DustinNgauv/Sparring-Roboter/Main/Screens.ino

void drawHomeScreen() {
  myGLCD.clrScr();
  myButtons.deleteAllButtons();
  myGLCD.setBackColor(0, 0, 0); // background color to black
  myGLCD.setColor(255, 255, 255); // font color to white
  myGLCD.setFont(GroteskBold24x48);

  // draws title
  myGLCD.print("Sparring Mode", CENTER, 15);
  myGLCD.drawLine(0, 80, 800, 80);

  // setting buttons
  myButtons.setTextFont(GroteskBold24x48);
  myButtons.setButtonColors(VGA_WHITE, VGA_GRAY, VGA_BLACK, VGA_WHITE, VGA_RED);  
  int Rounds_btn = myButtons.addButton(200, 100, 150, 60, "");
  int Speed_btn = myButtons.addButton(450, 100, 150, 60, "");
  int Time_btn = myButtons.addButton(200, 200, 150, 60, "");
  int Level_btn = myButtons.addButton(450, 200, 150, 60, "");
  int Rest_btn = myButtons.addButton(200, 300, 150, 60, "");
  int Volume_btn = myButtons.addButton(450, 300, 150, 60, "");
  
  myButtons.drawButtons();

  // start button
  myButtons.setButtonColors(VGA_WHITE, VGA_GRAY, VGA_BLACK, VGA_WHITE, 0x04A7);
  int Start_btn = myButtons.addButton(300, 380, 200, 80, "START");
  myButtons.drawButton(Start_btn);

  // print lables of the setting buttons
  myGLCD.setFont(SmallFont);
  myGLCD.setBackColor(255, 0, 0);
  myGLCD.print("Rounds", 253, 105);
  myGLCD.print("Speed", 506, 105);
  myGLCD.print("Time", 260, 205);
  myGLCD.print("Level", 509, 205);
  myGLCD.print("Rest", 262, 305);
  myGLCD.print("Strike Volume", 475, 305);

  // print current values of the settings
  myGLCD.setFont(BigFont);
  myGLCD.printNumI(rounds, 250, 125, 2);
  myGLCD.print(String(speed) + "%", 508, 125);
  myGLCD.print(millisToTimeStr(time), 230, 225);
  myGLCD.printNumI(level, 521, 225);
  myGLCD.print(millisToTimeStr(rest), 230, 325);
  myGLCD.printNumI(volume, 520, 325);

  // checks for user inputs and button presses
  while (true) {
    if (myTouch.dataAvailable()) {
      int pressed = myButtons.checkButtons();

      if (pressed == Rounds_btn) {
        drawRoundsScreen();
      } else if (pressed == Speed_btn) {


        drawSpeedScreen();
      } else if (pressed == Time_btn) {
        drawTimeScreen();
      } else if (pressed == Level_btn) {
        drawLevelScreen();
      } else if (pressed == Rest_btn) {
        drawRestScreen();
      } else if (pressed == Volume_btn) {
        drawVolumeScreen();
      } else if (pressed == Start_btn) {        
        drawSparringScreen();
      }     
    }
  }
}

void drawRoundsScreen() {
  myGLCD.clrScr();
  myButtons.deleteAllButtons();
  myGLCD.setBackColor(0, 0, 0);
  myGLCD.setColor(255, 255, 255);
  myGLCD.setFont(GroteskBold24x48);

  // draws title
  myGLCD.print("Choose Rounds", CENTER, 15);  
  myGLCD.drawLine(0, 80, 800, 80);

  // prints amount of rounds in the middle of the screen
  myGLCD.setFont(GroteskBold24x48);
  myGLCD.printNumI(rounds, CENTER, 220, 2);  

  // buttons to increase or decrease amount of rounds
  myButtons.setButtonColors(VGA_WHITE, VGA_GRAY, VGA_BLACK, VGA_BLACK, VGA_BLACK);
  int plus_btn = myButtons.addButton(500, 190, 100, 100, "+", BUTTON_NO_BORDER);
  int minus_btn = myButtons.addButton(200, 190, 100, 100, "-", BUTTON_NO_BORDER);
  myButtons.drawButtons();
  
  // ok button
  myButtons.setButtonColors(VGA_WHITE, VGA_GRAY, VGA_BLACK, VGA_WHITE, 0x04A7);
  int ok_btn = myButtons.addButton(300, 380, 200, 80, "OK");
  myButtons.drawButton(ok_btn);

  // checks for user inputs and button presses
  while (true) {     
    if (myTouch.dataAvailable()) {
    int pressed = myButtons.checkButtons();      
      
      if (pressed == ok_btn) {
        drawHomeScreen();
        break;
      }
      else if (pressed == plus_btn && rounds < 15) { // 15 rounds maximum
        rounds += 1;         
        myGLCD.printNumI(rounds, CENTER, 220, 2); // updates displayed value
      }

      else if (pressed == minus_btn && rounds > 1) { // 1 round mimimun
        rounds -= 1;           
        myGLCD.printNumI(rounds, CENTER, 220, 2); // updates displayed value
      }
    }
  }
}

void drawSpeedScreen() {
  myGLCD.clrScr();
  myButtons.deleteAllButtons();
  myGLCD.setBackColor(0, 0, 0);
  myGLCD.setColor(255, 255, 255);
  myGLCD.setFont(GroteskBold24x48);

  // draws title
  myGLCD.print("Adjust Speed", CENTER, 15);  
  myGLCD.drawLine(0, 80, 800, 80);

  // prints current speed setting
  myGLCD.setFont(GroteskBold24x48);
  myGLCD.printNumI(speed, CENTER, 220, 3);  
  myGLCD.print("%", 450, 220);

  // buttons to increase or decrease speed
  myButtons.setButtonColors(VGA_WHITE, VGA_GRAY, VGA_BLACK, VGA_BLACK, VGA_BLACK);
  int plus_btn = myButtons.addButton(500, 190, 100, 100, "+", BUTTON_NO_BORDER);
  int minus_btn = myButtons.addButton(200, 190, 100, 100, "-", BUTTON_NO_BORDER);
  myButtons.drawButtons();
  
  // ok button
  myButtons.setButtonColors(VGA_WHITE, VGA_GRAY, VGA_BLACK, VGA_WHITE, 0x04A7);
  int ok_btn = myButtons.addButton(300, 380, 200, 80, "OK");
  myButtons.drawButton(ok_btn);

  //checks for user input and button presses
  while (true) {     
    if (myTouch.dataAvailable()) {
    int pressed = myButtons.checkButtons();
      if (pressed == ok_btn) {
        drawHomeScreen();
        break;
      }
      else if (pressed == plus_btn && speed < 100) { // maximal speed at 100%
        speed += 5;         
        myGLCD.printNumI(speed, CENTER, 220, 3); // updates displayed value
      }

      else if (pressed == minus_btn && speed > 25) { // minimal speed at 25%
        speed -= 5;           
        myGLCD.printNumI(speed, CENTER, 220, 3); // updates displayed value
      }
    }
  }
}

void drawTimeScreen() {
  myGLCD.clrScr();
  myButtons.deleteAllButtons();
  myGLCD.setBackColor(0, 0, 0);
  myGLCD.setColor(255, 255, 255);
  myGLCD.setFont(GroteskBold24x48);

  // draws title
  myGLCD.print("Choose Time", CENTER, 15);  
  myGLCD.drawLine(0, 80, 800, 80);

  // prints the current duration of a round
  myGLCD.setFont(GroteskBold24x48);
  myGLCD.print(millisToTimeStr(time), CENTER, 220);  

  // buttons to increase or decrease duration
  myButtons.setButtonColors(VGA_WHITE, VGA_GRAY, VGA_BLACK, VGA_BLACK, VGA_BLACK);
  int plus_btn = myButtons.addButton(500, 190, 100, 100, "+", BUTTON_NO_BORDER);
  int minus_btn = myButtons.addButton(200, 190, 100, 100, "-", BUTTON_NO_BORDER);
  myButtons.drawButtons();
  
  myButtons.setButtonColors(VGA_WHITE, VGA_GRAY, VGA_BLACK, VGA_WHITE, 0x04A7);
  int ok_btn = myButtons.addButton(300, 380, 200, 80, "OK");
  myButtons.drawButton(ok_btn);

  // checks for user inputs and button presses
  while (true) {     
    if (myTouch.dataAvailable()) {
    int pressed = myButtons.checkButtons();
      if (pressed == ok_btn) {
        drawHomeScreen();
        break;
      }
      // maximal duration 10 minutes
      else if (pressed == plus_btn && time < 600000) { 
        time += 15000;         
        // updates displayed value
        myGLCD.print(millisToTimeStr(time), CENTER, 220);
      }
      // minimal duration 30 seconds
      else if (pressed == minus_btn && time > 30000) {
        time -= 15000;           
        // updates displayed value
        myGLCD.print(millisToTimeStr(time), CENTER, 220);
      }
    }
  }
}

void drawLevelScreen() {
  myGLCD.clrScr();
  myButtons.deleteAllButtons();
  myGLCD.setBackColor(0, 0, 0);
  myGLCD.setColor(255, 255, 255);
  myGLCD.setFont(GroteskBold24x48);

  // draws title
  myGLCD.print("Choose Level", CENTER, 15);  
  myGLCD.drawLine(0, 80, 800, 80);

  // level buttons 1-3
  myGLCD.setFont(SevenSegment96x144Num);
  myButtons.setButtonColors(VGA_WHITE, VGA_GRAY, VGA_BLACK, VGA_WHITE, VGA_RED);
  int Lvl1_btn = myButtons.addButton(120, 190, 100, 100, "1");
  int Lvl2_btn = myButtons.addButton(350, 190, 100, 100, "2");
  int Lvl3_btn = myButtons.addButton(580, 190, 100, 100, "3");

  myButtons.drawButtons();

  // checks for user input and button presses
  while (true) {     
    if (myTouch.dataAvailable()) {
    int pressed = myButtons.checkButtons();
      if (pressed == Lvl1_btn) {
        level = 1;
        drawHomeScreen();
        break;
      }
      else if (pressed == Lvl2_btn) {
        level = 2;
        drawHomeScreen();
        break;
      }
      else if (pressed == Lvl3_btn) {
        level = 3;
        drawHomeScreen();
        break;
      }
    }
  }
}

void drawRestScreen() {
  myGLCD.clrScr();
  myButtons.deleteAllButtons();
  myGLCD.setBackColor(0, 0, 0);
  myGLCD.setColor(255, 255, 255);
  myGLCD.setFont(GroteskBold24x48);

  // draws title
  myGLCD.print("Choose Rest", CENTER, 15);  
  myGLCD.drawLine(0, 80, 800, 80);

  // prints current resting time
  myGLCD.setFont(GroteskBold24x48);
  myGLCD.print(millisToTimeStr(rest), CENTER, 220);  

  // buttons to increase or decrease resting time
  myButtons.setButtonColors(VGA_WHITE, VGA_GRAY, VGA_BLACK, VGA_BLACK, VGA_BLACK);
  int plus_btn = myButtons.addButton(500, 190, 100, 100, "+", BUTTON_NO_BORDER);
  int minus_btn = myButtons.addButton(200, 190, 100, 100, "-", BUTTON_NO_BORDER);
  myButtons.drawButtons();
  
  // ok button
  myButtons.setButtonColors(VGA_WHITE, VGA_GRAY, VGA_BLACK, VGA_WHITE, 0x04A7);
  int ok_btn = myButtons.addButton(300, 380, 200, 80, "OK");
  myButtons.drawButton(ok_btn);

  // checks for user inputs and button presses
  while (true) {     
    if (myTouch.dataAvailable()) {
    int pressed = myButtons.checkButtons();
      if (pressed == ok_btn) {
        drawHomeScreen();
        break;
      }
      // maximal resting time 5 minutes
      else if (pressed == plus_btn && rest < 300000) {
        rest += 10000;         
        // updates displayed value
        myGLCD.print(millisToTimeStr(rest), CENTER, 220);
      }
      // minimal resting time 10 seconds
      else if (pressed == minus_btn && rest > 10000) {
        rest -= 10000;           
        // updates displayed value
        myGLCD.print(millisToTimeStr(rest), CENTER, 220); 
      }
    }
  }
}

void drawVolumeScreen() {
  myGLCD.clrScr();
  myButtons.deleteAllButtons();
  myGLCD.setBackColor(0, 0, 0);
  myGLCD.setColor(255, 255, 255);
  myGLCD.setFont(GroteskBold24x48);

  // draws title
  myGLCD.print("Choose Strike Volume", CENTER, 15);  
  myGLCD.drawLine(0, 80, 800, 80);

  // prints the current amount of consecutive strikes
  myGLCD.setFont(GroteskBold24x48);
  myGLCD.printNumI(volume, CENTER, 220);  

  // buttons to increase or decrease strike volume
  myButtons.setButtonColors(VGA_WHITE, VGA_GRAY, VGA_BLACK, VGA_BLACK, VGA_BLACK);
  int plus_btn = myButtons.addButton(500, 190, 100, 100, "+", BUTTON_NO_BORDER);
  int minus_btn = myButtons.addButton(200, 190, 100, 100, "-", BUTTON_NO_BORDER);
  myButtons.drawButtons();
  
  // ok button
  myButtons.setButtonColors(VGA_WHITE, VGA_GRAY, VGA_BLACK, VGA_WHITE, 0x04A7);
  int ok_btn = myButtons.addButton(300, 380, 200, 80, "OK");
  myButtons.drawButton(ok_btn);

  // checks for user input and button presses
  while (true) {     
    if (myTouch.dataAvailable()) {
    int pressed = myButtons.checkButtons();
      if (pressed == ok_btn) {
        drawHomeScreen();
        break;
      }
      // maximal consecutive strikes 4
      else if (pressed == plus_btn && volume < 4) {
        volume += 1;         
        // updates displayed value
        myGLCD.printNumI(volume, CENTER, 220); 
      }
      // minimal consecutive strikes 1
      else if (pressed == minus_btn && volume > 1) { 
        volume -= 1;           
        // updates displayed value
        myGLCD.printNumI(volume, CENTER, 220); 
      }
    }
  }
}

void drawSparringScreen() {
  myGLCD.clrScr();
  myButtons.deleteAllButtons();
  myGLCD.setBackColor(0, 0, 0);
  myGLCD.setColor(255, 255, 255);
  myGLCD.setFont(SevenSegment96x144Num);

  // holds the amount of seconds since the board has been started up
  unsigned long initialseconds = millis() / 1000;   
  // either holds the value of the round duration or of the resting duration  
  unsigned long duration; 
  // holds the value to reset the countdown clock
  unsigned long added_time = 0;  
  int currentRound = 1;
  float progress = 0.0;
  String TimeString;

  // holds the amount of time between each set of attacks
  unsigned long delaybetween; 
  unsigned long time1 = 0;
  unsigned long time2 = 0;         

  // stop button
  myGLCD.setFont(GroteskBold24x48);
  myButtons.setTextFont(GroteskBold24x48);
  myButtons.setButtonColors(VGA_WHITE, VGA_GRAY, VGA_BLACK, VGA_WHITE, VGA_RED);
  int StopSpar_btn = myButtons.addButton(300, 380, 200, 80, "QUIT");

  // loops for the total amount of rounds, rest times and the initial countdown  
  for (int i = 0; i < (2 * rounds); i++) { 
    if (i != 0) {

      // prints the current round
      myButtons.drawButtons();
      myGLCD.print("Round " + String(currentRound) + "/" + String(rounds), CENTER, 50);
      myGLCD.fillRoundRect(100, 315, 700, 300);
    }

    if (i % 2 == 1) {            
      duration = time;
      myGLCD.print("   FIGHT!   ", CENTER, 120);         
    }

    else if (i % 2 == 0 && i != 0) {
      currentRound += 1;
      duration = rest;     
      myGLCD.print("Resting", CENTER, 120);               
    }

    while (true) { 
      
      // sets the delay between each set of attacks 
      // based on level, strike volume and speed settings
      switch (level) {
        case 1:
        // 2500ms delay time
        delaybetween = volume * servoDuration(speed) + 2500; 
        break;

        case 2:    
        // 1500ms delay time
        delaybetween = volume * servoDuration(speed) + 1500; 
        break;

        case 3:   
        // random delay time between 500ms and 4000ms
        delaybetween = volume * servoDuration(speed) + random(500, 4000); 
        break;
      }          

      // checks for user input and button presses
      if (myTouch.dataAvailable()) {
      int pressed = myButtons.checkButtons();
        if (pressed == StopSpar_btn) {
          drawHomeScreen();
          break;
        }
      }  

      // executes a set of strikes after the given time
      if (millis() >= delaybetween + time1 + initialseconds * 1000) {
        time1 += delaybetween;  
        if (i % 2 == 1) {          
          SparringMode();           
        }                                           
      }            

      // updates the countdown clock every 100ms
      if (millis() >= 100 + time2 + initialseconds * 1000) {
        time2 += 100;
        if (i == 0) {
          countdowntime = 5 + initialseconds + added_time - (millis() / 1000);  // initial 5 second preparation countdown
          TimeString = countdowntime % 60;    
          
          // displays the preparation countdown
          myGLCD.setFont(SevenSegment96x144Num);
          myGLCD.print(TimeString, CENTER, 150);
          myGLCD.setFont(GroteskBold24x48);
        }              
        
        else {
          // countdown clock during round or rest times
          countdowntime = (duration / 1000) + initialseconds + added_time - (millis() / 1000); 
          // calculates current progress
          progress = 1 - (countdowntime / float(duration / 1000)); 
          
          unsigned long countdown_minute = ((countdowntime / 60) % 60);
          unsigned long countdown_sec = countdowntime % 60;
                  
          if (countdown_sec < 10) {
            TimeString = String(countdown_minute) + ":" + "0" + String(countdown_sec);
          }

          else {
            TimeString = String(countdown_minute) + ":" + String(countdown_sec);
          }

          // displays countdown clock
          myGLCD.print(TimeString, CENTER, 200);      
          myGLCD.setColor(0, 26, 255);
          myGLCD.fillRoundRect(100, 315, 100 + progress * 600, 300);            
          myGLCD.setColor(255, 255, 255);
        }                  

        // checks if round or rest time has ended
        if (countdowntime == 0 || countdowntime > 4000000000) { 
          myGLCD.clrScr();      
          break;
        }
      }            
    }

    // checks if sparring has finished
    if ((countdowntime == 0 || countdowntime > 4000000000) && (i + 1) == (2 * rounds)) {
      delay(1000);
      drawHomeScreen();
      break;
    } 

    // resets countdown clock
    added_time = (millis() / 1000) - initialseconds;
  } 
}
